eagletrt/fenice-bms-lv/docs/media/mcp23017 feedbacks.png

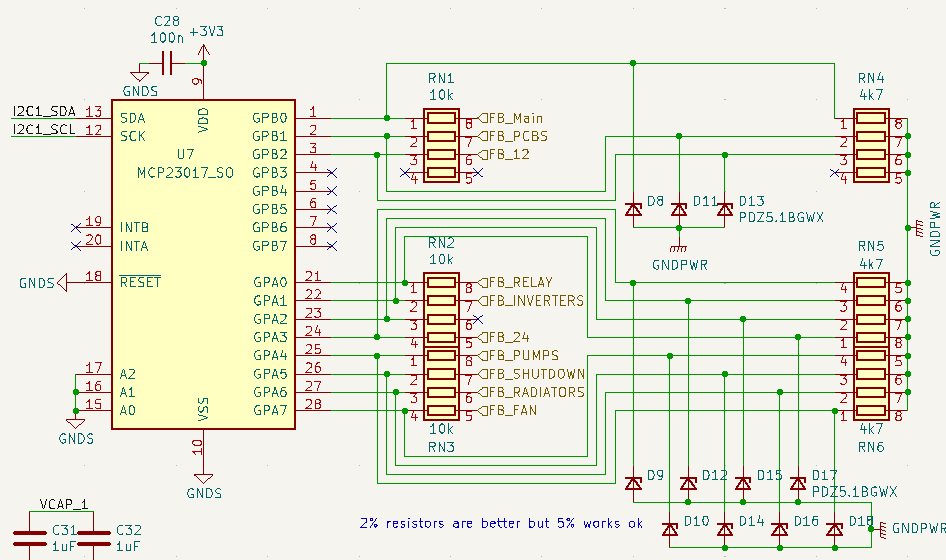
docs/media/mcp23017 feedbacks.png
