eagletrt/fenice-bms-lv/docs/media/pinout_mcu.png

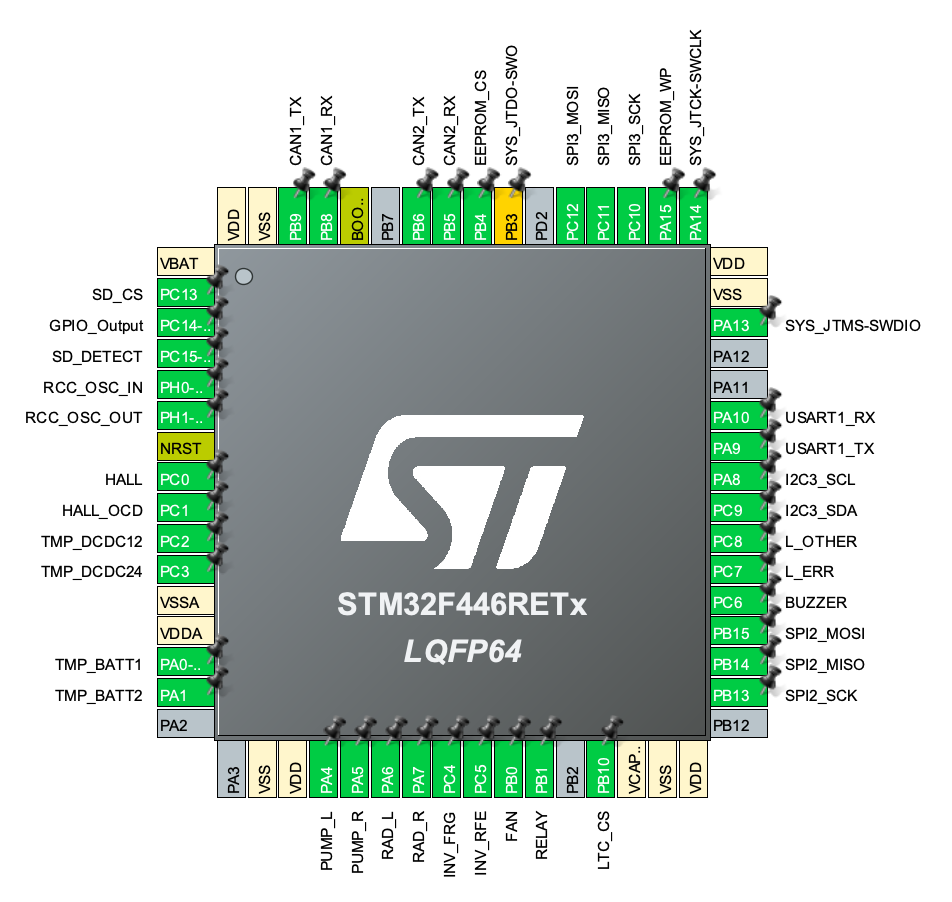
docs/media/pinout_mcu.png
