eagletrt/fenice-bms-lv/Doc/fenice-bms-lv-hw.pdf

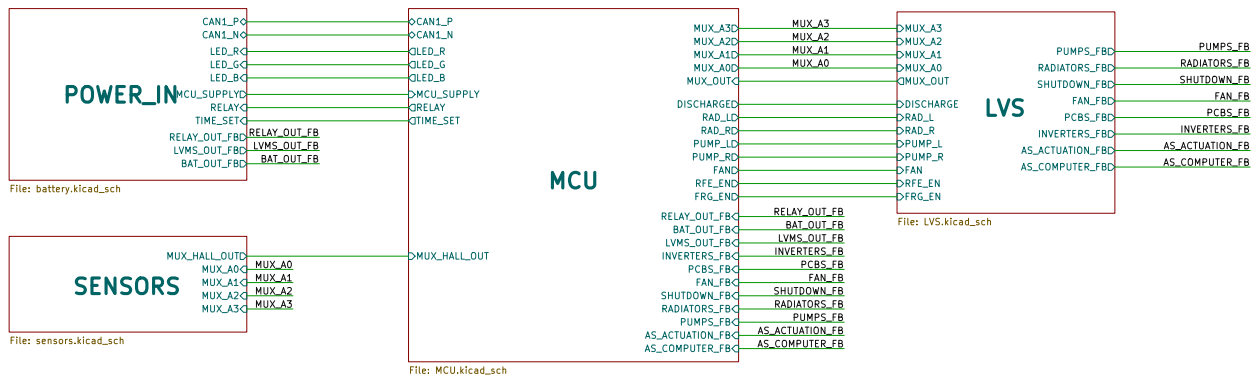
[picture p7: page 1]

File: fenice-bms-lv-hw.kicad_sch Sheet: / E-Agle TRT

Id: 1/5 Title: Fenice BMS LV

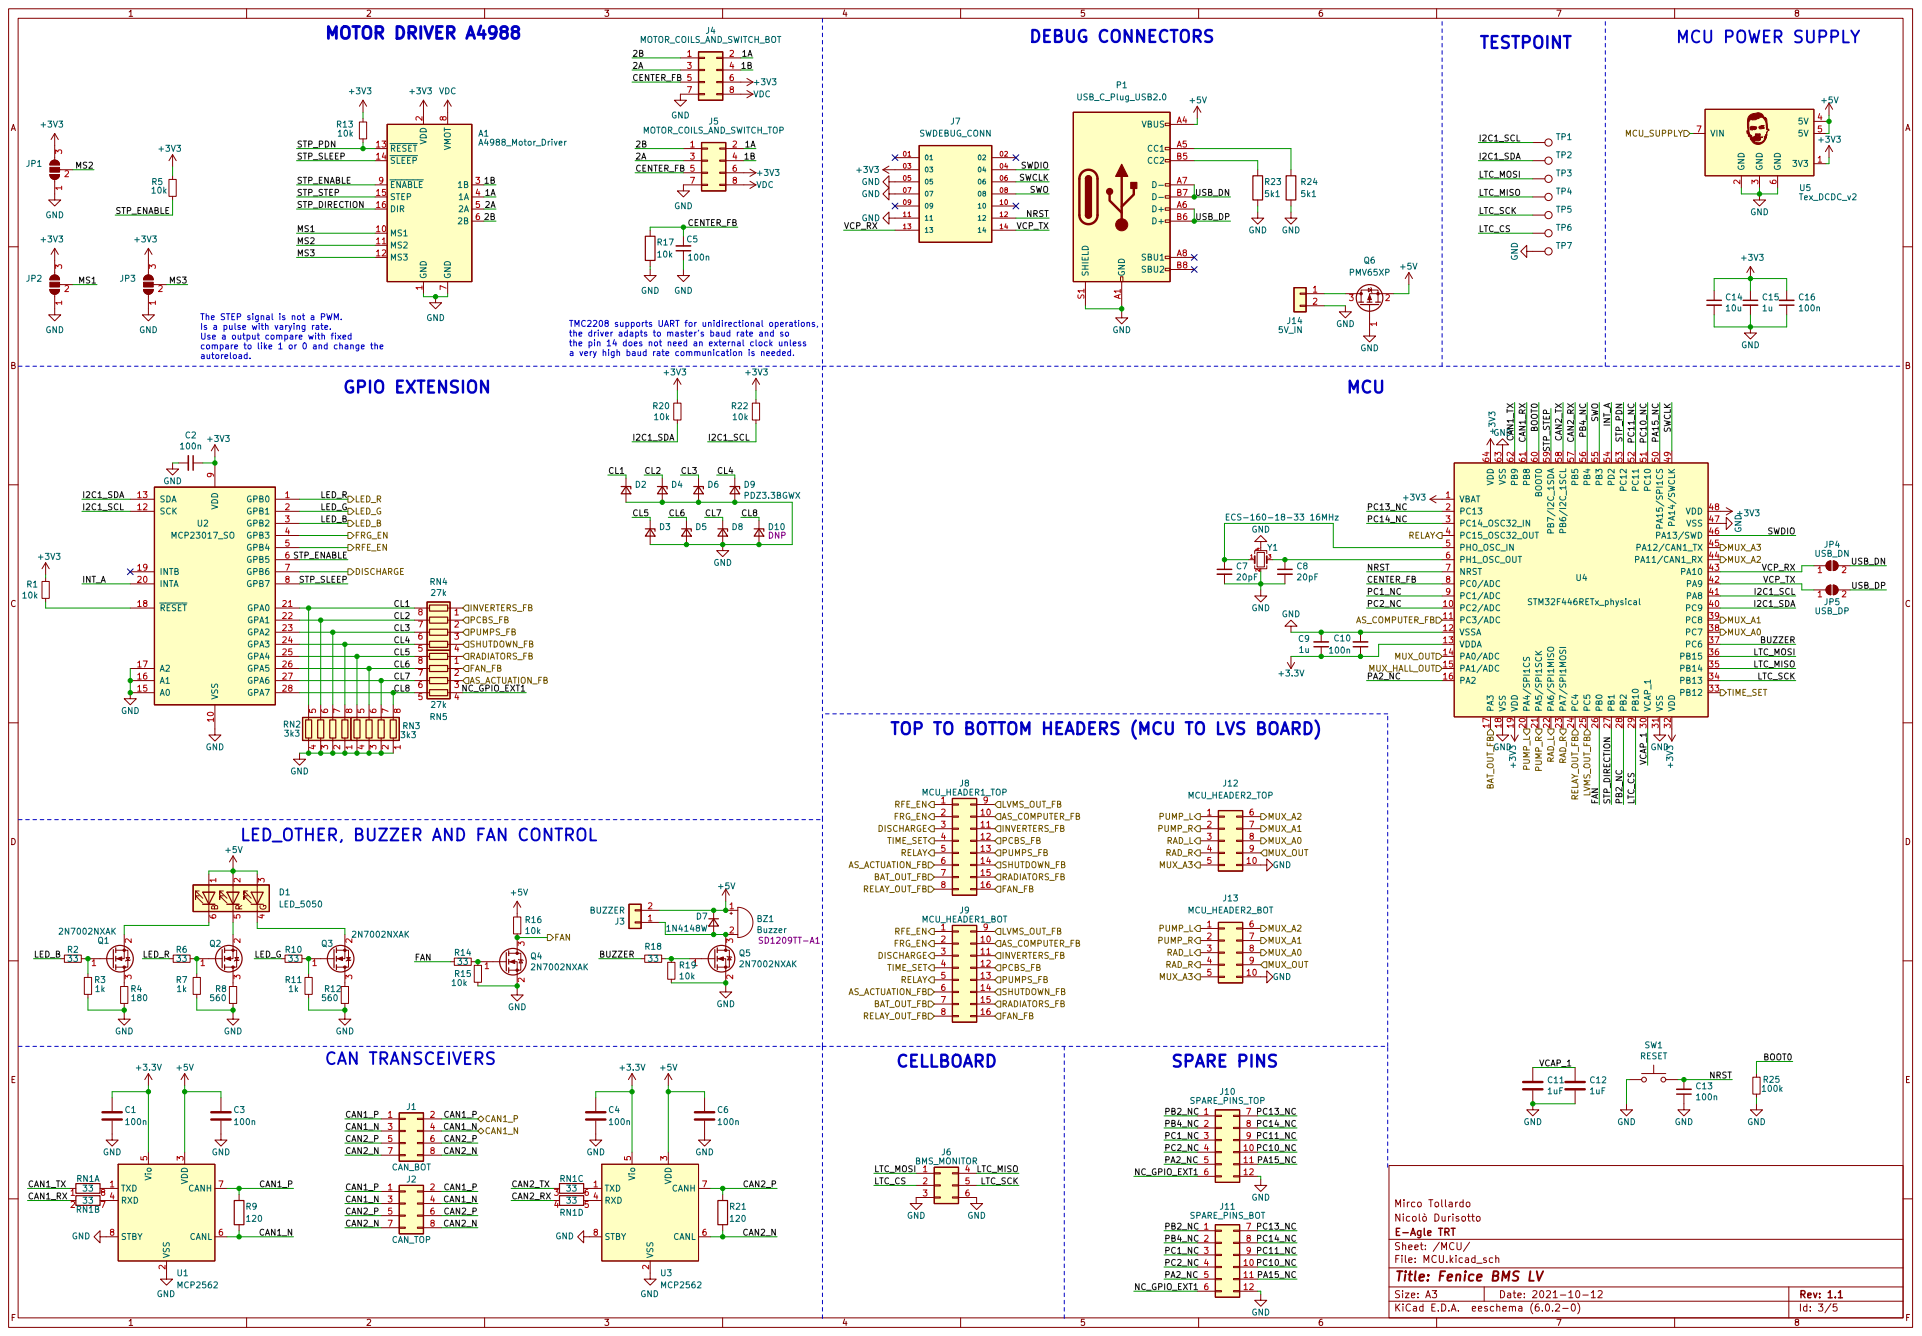
[picture p8: page 2]

1 MS1 10 MS2 11 MS3 12 ~{RESET} 13 ~{SLEEP} 14 STEP 15 DIR 16 VDD

The STEP signal is not a PWM.
Is a pulse with varying rate.
Use a output compare with fixed

TMC2208 supports UART for unidirectional operations,
the driver adapts to master's baud rate and so
the pin 14 does not need an external clock unless
a very high baud rate communication is needed.

LED_OTHER, BUZZER AND FAN CONTROL

5 CANL 6 CANH 7 STBY 8 U3MCP2562 GND GND

5 CANL 6 CANH 7 STBY 8 U1MCP2562 GND

File: MCU.kicad_sch Sheet: /MCU/ E-Agle TRT

Id: 3/5 Title: Fenice BMS LV

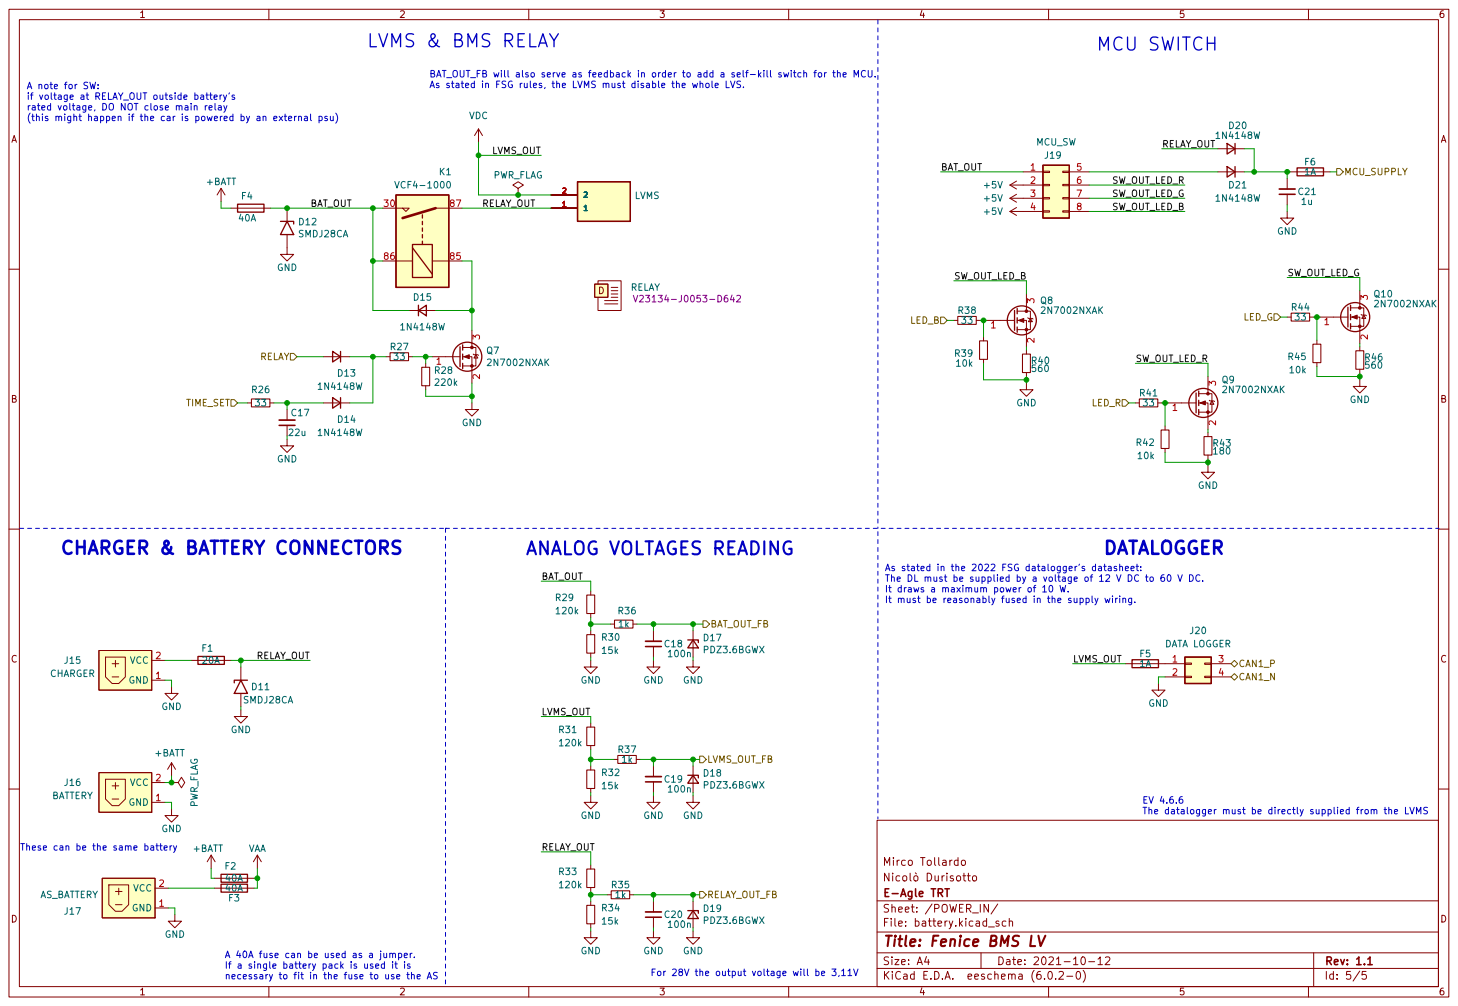
[picture p9: page 3]

A note for SW:
if voltage at RELAY_OUT outside battery's
rated voltage, DO NOT close main relay
(this might happen if the car is powered by an external psu)

The DL must be supplied by a voltage of 12 V DC to 60 V DC.
It draws a maximum power of 10 W.
It must be reasonably fused in the supply wiring.

EV 4.6.6 The datalogger must be directly supplied from the LVMS

These can be the same battery

E-Agle TRT
Sheet: /POWER_IN/
File: battery.kicad_sch
Id: 5/5 Title: Fenice BMS LV

A 40A fuse can be used as a jumper.
If a single battery pack is used it is
necessary to fit in the fuse to use the AS

For 28V the output voltage will be 3,11V

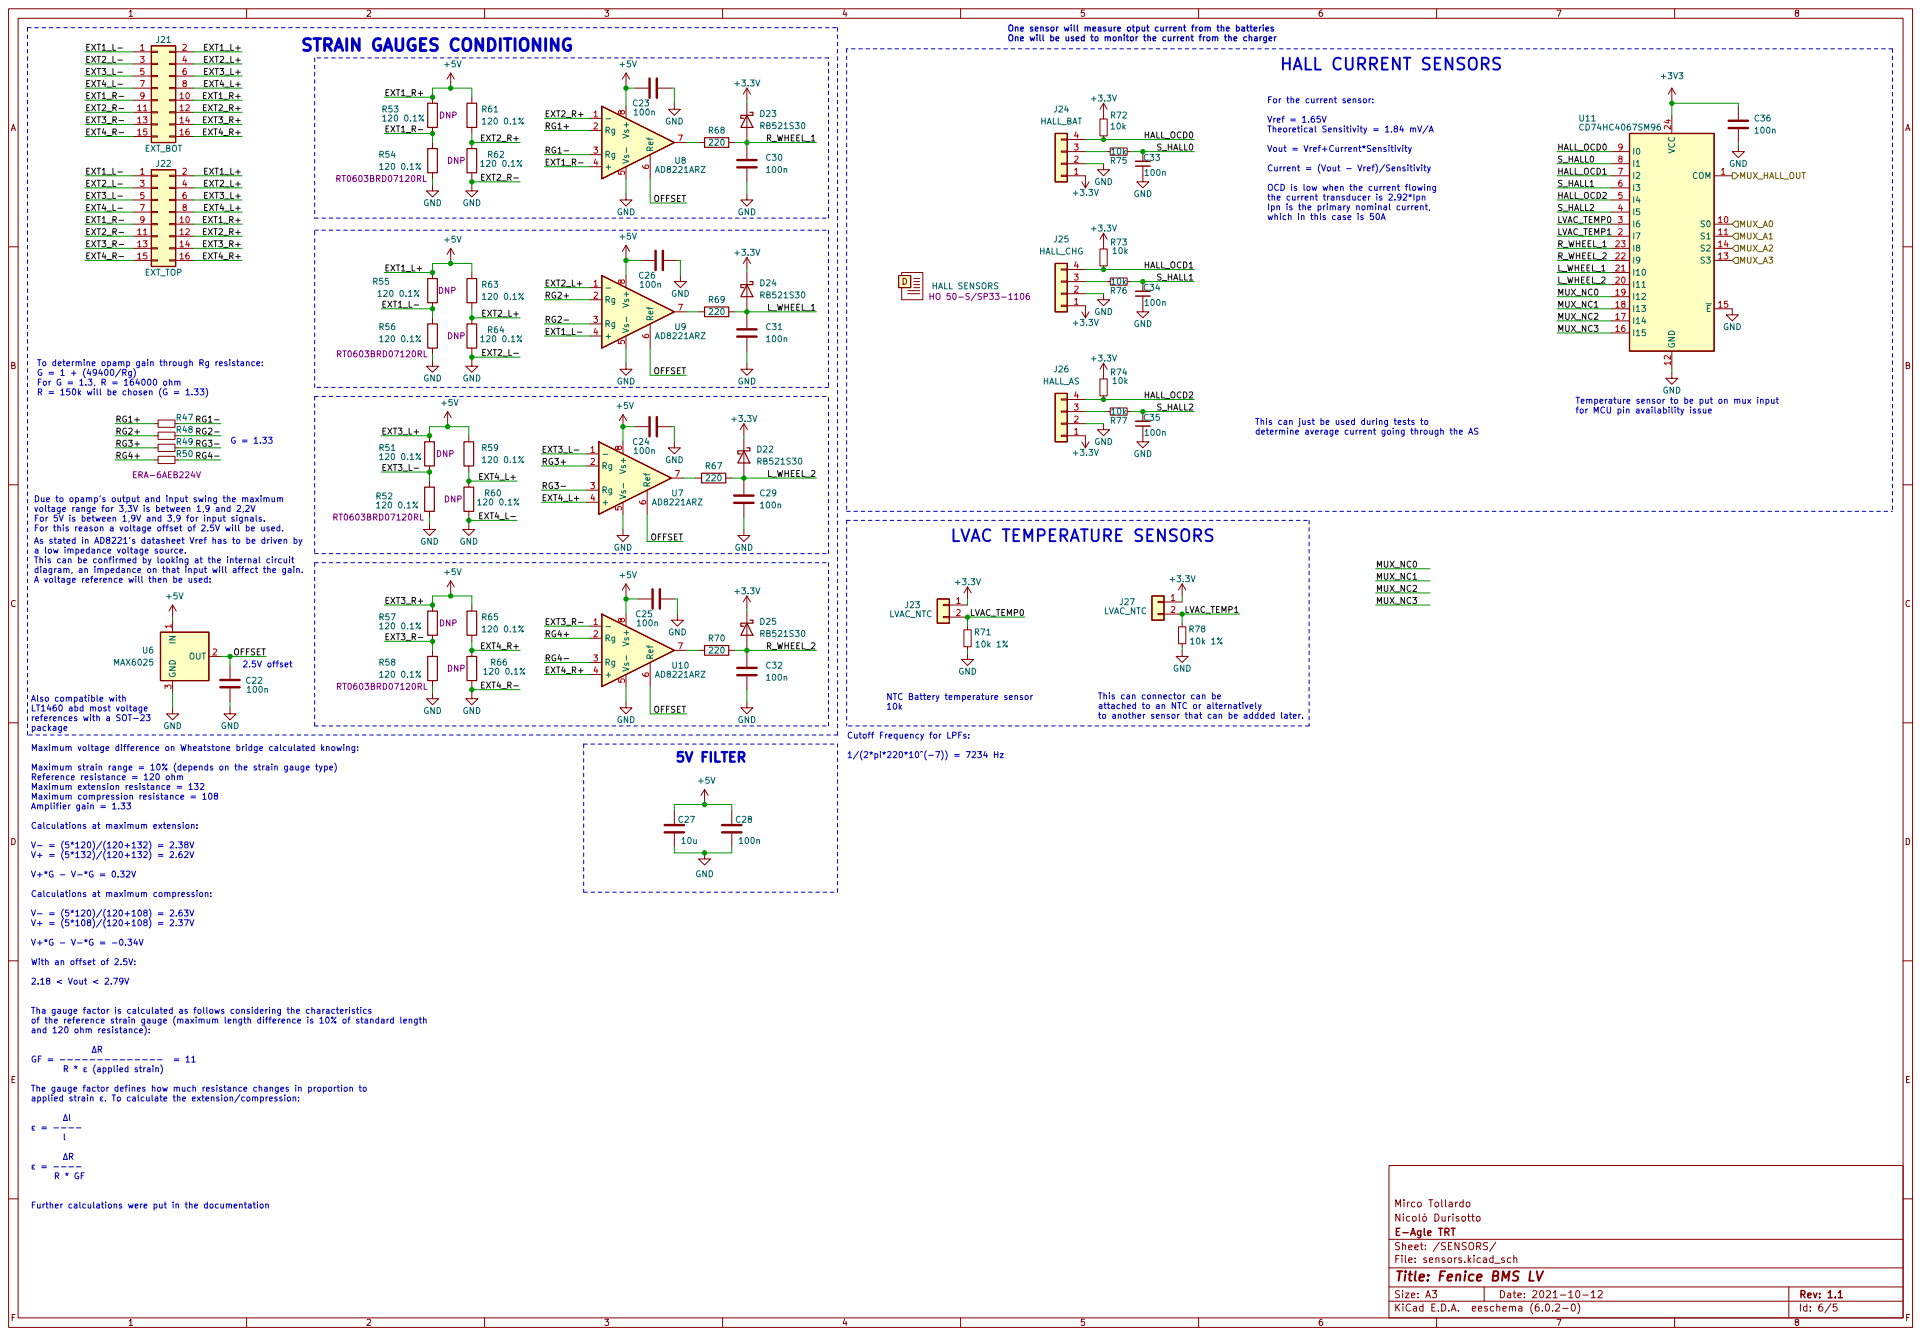
[picture p10: page 4]

One sensor will measure otput current from the batteries
One will be used to monitor the current from the charger

Ipn is the primary nominal current, which in this case is 50A STRAIN GAUGES CONDITIONING

For the current sensor: Vref = 1.65V

Vout = Vref+Current*Sensitivity

Current = (Vout - Vref)/Sensitivity

OCD is low when the current flowing
the current transducer is 2.92*Ipn

to another sensor that can be addded later. To determine opamp gain through Rg resistance:
G = 1 + (49400/Rg) For G = 1.3, R = 164000 ohm

Temperature sensor to be put on mux input
for MCU pin availability issue

This can just be used during tests to
determine average current going through the AS

Due to opamp's output and input swing the maximum
voltage range for 3,3V is between 1,9 and 2,2V
For 5V is between 1,9V and 3,9 for input signals.
As stated in AD8221's datasheet Vref has to be driven by
a low impedance voltage source.
This can be confirmed by looking at the internal circuit
diagram, an impedance on that input will affect the gain.
A voltage reference will then be used:

This can connector can be attached to an NTC or alternatively

Also compatible with
LT1460 abd most voltage references with a SOT-23

Cutoff Frequency for LPFs:

Maximum voltage difference on Wheatstone bridge calculated knowing:

Maximum strain range = 10% (depends on the strain gauge type) Reference resistance = 120 ohm

Maximum extension resistance = 132 Maximum compression resistance = 108

Amplifier gain = 1.33 Calculations at maximum extension: V- = (5*120)/(120+132) = 2.38V

V+*G - V-*G = 0.32V Calculations at maximum compression:

V+*G - V-*G = -0.34V With an offset of 2.5V: 2.18 < Vout < 2.79V

Tha gauge factor is calculated as follows considering the characteristics
of the reference strain gauge (maximum length difference is 10% of standard length
and 120 ohm resistance):

The gauge factor defines how much resistance changes in proportion to

Further calculations were put in the documentation

File: sensors.kicad_sch Sheet: /SENSORS/ E-Agle TRT

Id: 6/5 Title: Fenice BMS LV

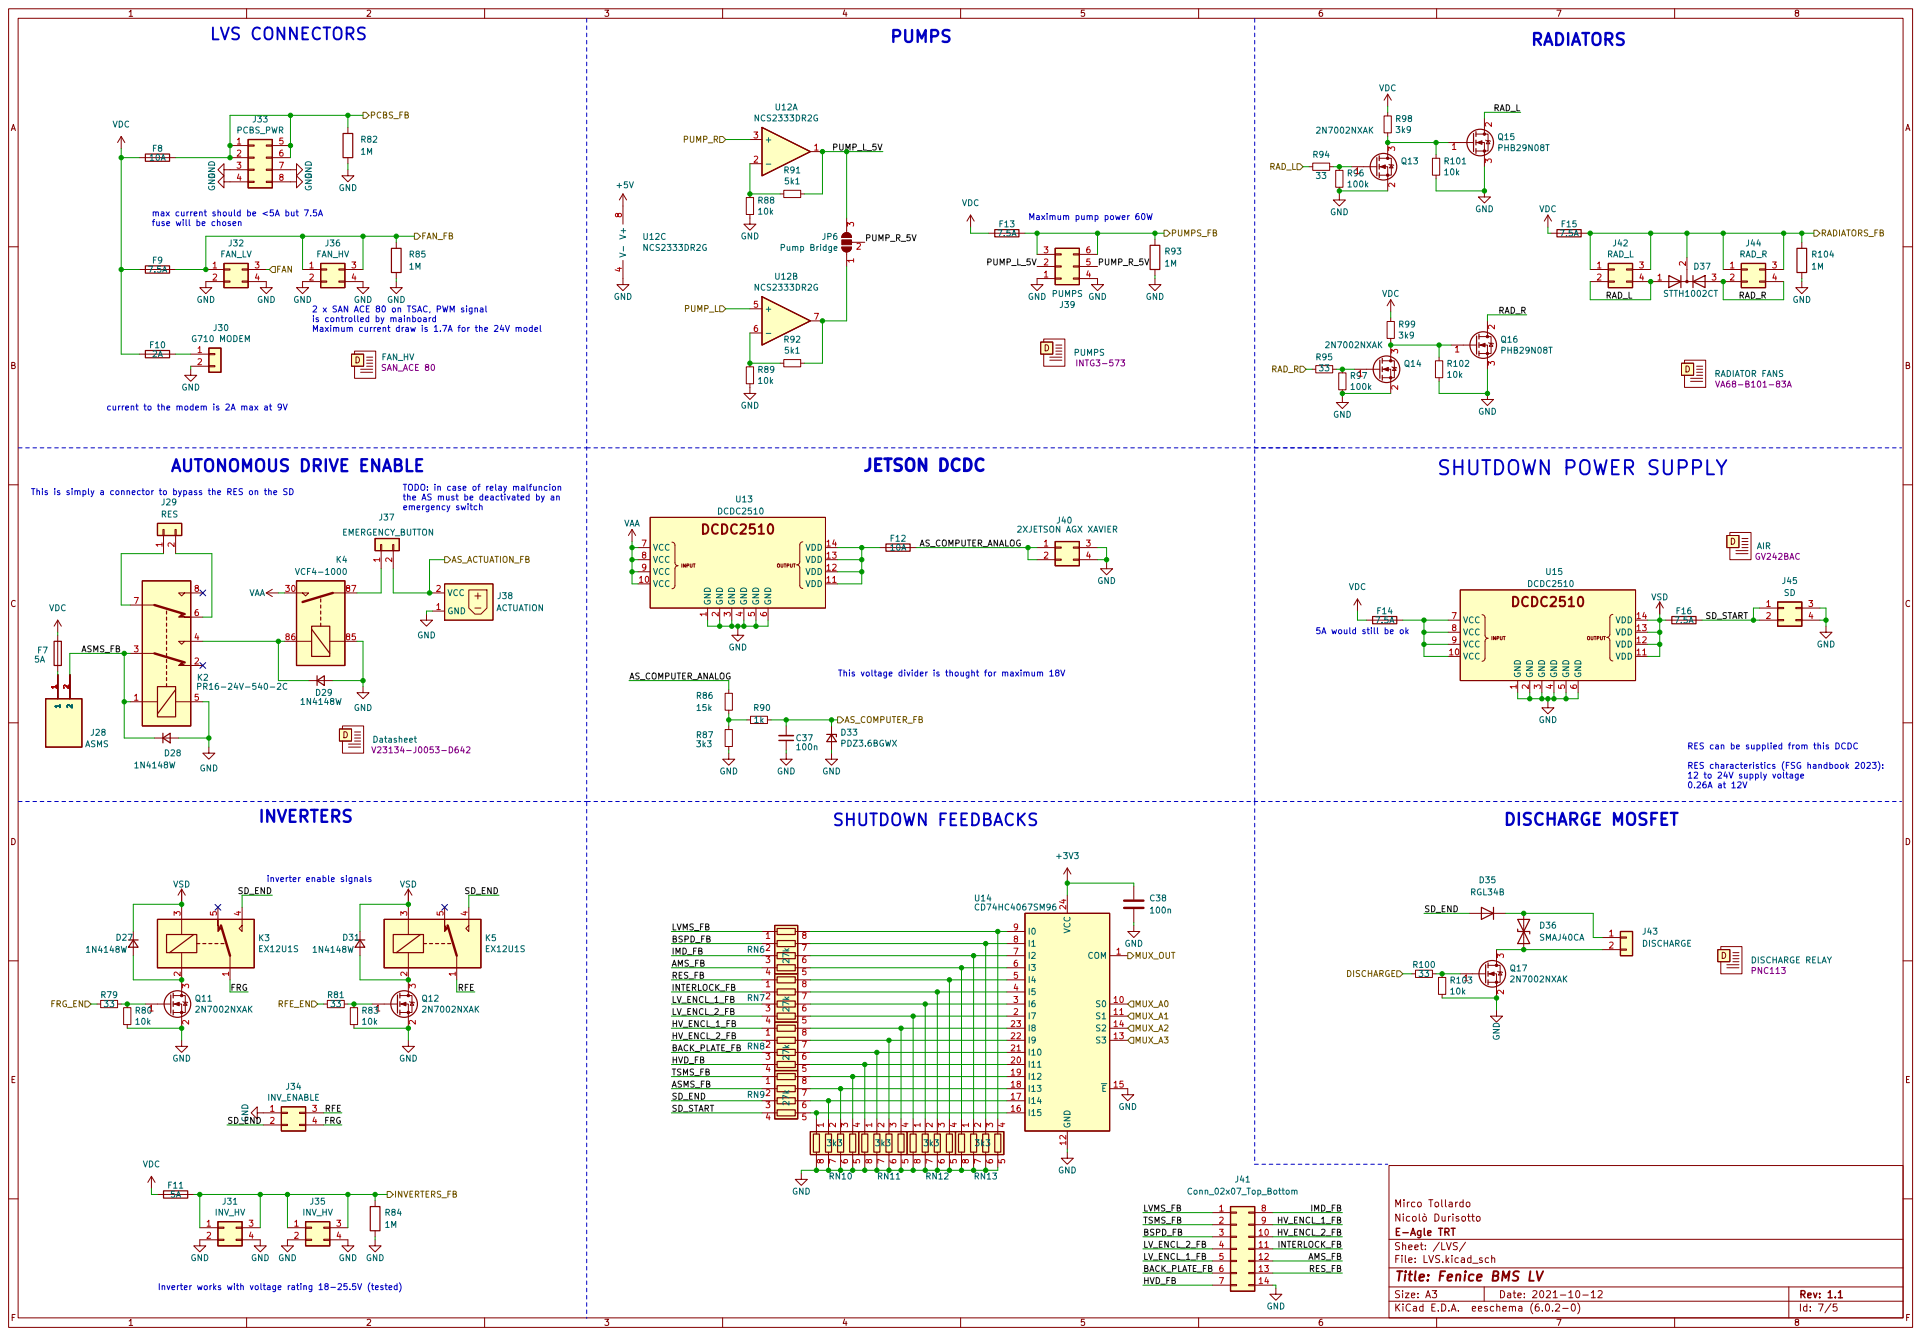
[picture p11: page 5]

max current should be <5A but 7.5A
fuse will be chosen

6 VCC 7 VCC 8 VCC 9 U15 DCDC2510 GND GND GND GNDV- 4 V+
J32 FAN_LV GND

2 x SAN ACE 80 on TSAC, PWM signal
is controlled by mainboard Maximum current draw is 1.7A for the 24V model

This is simply a connector to bypass the RES on the SD

TODO: in case of relay malfuncion
the AS must be deactivated by an
emergency switch

1 VCC 10 VDD 11 VDD 12 VDD 13 VDD 14 GND

This voltage divider is thought for maximum 18V

RES characteristics (FSG handbook 2023):
12 to 24V supply voltage

þÿNicolò Durisotto Mirco Tollardo GND

File: LVS.kicad_sch Sheet: /LVS/ E-Agle TRT

Id: 7/5 Title: Fenice BMS LV

Inverter works with voltage rating 18-25.5V (tested)
