eagletrt/fenice-bms-lv/Core/Src/main.c

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
/* Includes ------------------------------------------------------------------*/
#include "main.h"

#include "can.h"
#include "dac.h"
#include "gpio.h"
#include "i2c.h"
#include "spi.h"
#include "tim.h"
#include "usart.h"

/* USER CODE BEGIN Includes */
#include "adc.h"
#include "can_comm.h"
#include "cli_bms_lv.h"
#include "common.h"
#include "current_sensor.h"
#include "current_transducer.h"
#include "dac_pump.h"
#include "dma.h"
#include "error.h"
#include "fenice-config.h"
#include "health_signals.h"
#include "inverters.h"
#include "mcp23017.h"
#include "measurements.h"
#include "monitor_int.h"
#include "notes_buzzer.h"
#include "pwm.h"
#include "radiator.h"
#include "stdio.h"
#include "string.h"
#include "thermocouple.h"
#include "timer_utils.h"
/* USER CODE END Includes */

/* USER CODE BEGIN PTD */

/*----------------------------------- ERRORS ---------------------------------*/

bool is_bms_on_fault                   = false;
bool is_relay_closed                   = false;
bool is_lvms_closed_for_the_first_time = false;
/* USER CODE END PTD */


/* USER CODE BEGIN PV */
Inverters_struct car_inverters;
/* USER CODE END PV */

void SystemClock_Config(void);
/* USER CODE BEGIN PFP */
void bms_error_state();
void cooling_routine();
void lv_under_v_alert();
void check_lvms();
static inline void check_initial_voltage();
static inline void fans_radiators_pumps_init();
void set_flash_pin();
/* USER CODE END PFP */

/* USER CODE BEGIN 0 */
int debug_flag  = 0;
int m_sec_timer = 0;

HAL_StatusTypeDef status;
char main_buff[500];
float bms_fan_duty_cycle = 0.8;
bool cooling_update      = false;
uint32_t init_timer;
/* USER CODE END 0 */

/**
  * @brief  The application entry point.
  * @retval int
  */
int main(void) {
    /* MCU Configuration--------------------------------------------------------*/

    /* Reset of all peripherals, Initializes the Flash interface and the Systick. */
    HAL_Init();

    /* Configure the system clock */
    SystemClock_Config();

    /* Initialize all configured peripherals */
    MX_GPIO_Init();
    MX_CAN2_Init();
    MX_DAC_Init();
    MX_I2C3_Init();
    MX_SPI2_Init();
    MX_TIM2_Init();
    MX_TIM3_Init();
    MX_USART1_UART_Init();
    MX_CAN1_Init();
    MX_TIM8_Init();
    MX_TIM5_Init();
    MX_TIM7_Init();
    MX_TIM4_Init();
    MX_UART5_Init();
    MX_TIM10_Init();
    MX_TIM1_Init();
    /* USER CODE BEGIN 2 */
    /* USER CODE BEGIN 2 */

    //  MX_DMA_Init() must be executed before MX_ADC_Init() otherwise the ADC doesnt' work in DMA mode correctly
    //  but since __CUBEMIX e' stronzo__(cit.), this isn't enforced by the code generator
    //  threfore manual intervention is necessary
    //  https://community.st.com/s/question/0D50X0000ALudz8SQB/how-to-enable-adc-continuous-mode-with-dma

    MX_DMA_Init();
    MX_ADC1_Init();
    MX_ADC2_Init();

    // Usefull if it's necessary to stop the timer counter when debugging
#ifdef DEBUG_TIMER_MCU
    DBGMCU->APB2FZ = DBGMCU_APB2_FZ_DBG_TIM10_STOP;
#endif

    // START OF WARM UP STAGE
    lv_status.status = PRIMARY_LV_STATUS_STATUS_INIT_CHOICE;
    // Turn on startup button
    // TODO: change button pin

    // Blink to signal correct MX_XXX_init processes (usuefull for CAN transciever)
    cli_bms_lv_init();
    error_init();
    health_init(&hs);

    //Init ADC related stuff
    ADC_init_status_flags();
    ADC_init_mux();
    ADC_Vref_Calibration();
    ADC_start_ADC2_readings();

    monitor_init();

    init_inverter_struct(&car_inverters);
    //Init feedbacks chip
    mcp23017_basic_config_init(&hmcp, &hi2c3);
    radiator_init();
    dac_pump_handle_init(&hdac_pump, 0.0, 0.0);
    dac_pump_store_and_set_value_on_both_channels(&hdac_pump, 0.0, 0.0);

    // Buzzer congiguration
    pwm_set_period(&BZZR_HTIM, 1);
    pwm_set_duty_cicle(&BZZR_HTIM, BZZR_PWM_TIM_CHNL, 0.25);

    // Other fan, set at 25 KHz
    // pwm_set_period(&INTERNAL_FAN_HTIM, 0.04);
    // pwm_set_duty_cicle(&INTERNAL_FAN_HTIM, INTERNAL_FAN_PWM_TIM_CHNL, 0.9);
    // pwm_start_channel(&INTERNAL_FAN_HTIM, INTERNAL_FAN_PWM_TIM_CHNL);
    // pwm_start_channel(&BZZR_HTIM, BZZR_PWM_TIM_CHNL);

    // Keeps SPI CS high
    // ltc6810_disable_cs(&SPI);
#ifdef DEBUG_LTC_ID
    sprintf(main_buff, "LTC ID %s", ltc6810_return_serial_id());
    printl(main_buff, NO_HEADER);
#endif

    printl("Relay out disabled, waiting 0.5 seconds before reading voltages\r\n", NO_HEADER);
    HAL_Delay(500);

    check_initial_voltage();
    set_flash_pin();
    check_lvms();

    //fans_radiators_pumps_init();

    //init for both can
    can_primary_init();
    can_secondary_init();

    measurements_init(&MEASUREMENTS_TIMER);
    // END OF WARM UP STAGE

    /* USER CODE END 2 */

    /* Infinite loop */
    /* USER CODE BEGIN WHILE */
    init_timer = HAL_GetTick();
    mcp23017_set_gpio(&hmcp, MCP23017_PORTB, LED_R, 1);
    if (lv_status.status == PRIMARY_LV_STATUS_STATUS_INIT_CHOICE) {
        lv_status.status = PRIMARY_LV_STATUS_STATUS_RUN_CHOICE;
    }

    //start timer for cooling routine
    HAL_TIM_Base_Start_IT(&htim7);
    //static bool first = true;
    while (1) {
        // Running stage
        if (lv_status.status == PRIMARY_LV_STATUS_STATUS_ERROR_CHOICE) {
            bms_error_state();
        } else {
            ADC_Routine();
            if (HAL_GetTick() - init_timer > 3000) {
                measurements_flags_check();
            }

            inverters_loop(&car_inverters);
            if (lv_thresholds_handler.first_threshold_reached || lv_thresholds_handler.second_threshold_reached) {
                lv_under_v_alert();
            }
            if (cooling_update) {
                cooling_routine();
                cooling_update = false;
            }
            cli_loop(&cli_bms_lv);
        }
    }
    /* USER CODE END WHILE */

    /* USER CODE BEGIN 3 */
    // }
    /* USER CODE END 3 */
}

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
/* USER CODE BEGIN 4 */

/* Exported functions --------------------------------------------------------*/

/**
  * @brief  RCC Clock Security System interrupt callback
  * @retval None
  */
void HAL_RCC_CSSCallback(void) {
    //TODO change into something meaningfull
    for (int i = 0; i < 3; i++) {
        //HAL_GPIO_TogglePin(LED_ERR_GPIO_Port, LED_ERR_Pin);
        HAL_Delay(100);
    }
}

/**
 * @brief Checks if total voltage is above MIN_POWER_ON_VOLTAGE within VOLT_MAX_ATTEMPTS times
 * If total voltage is above the minimum level required the buzzer starts up for BUZZER_ALARM_TIME
 * 
 */
static inline void check_initial_voltage() {
    sprintf(main_buff, "Checking if total voltage on board is above %.2fV", MIN_POWER_ON_VOLTAGE);
    for (uint8_t i = 0; i < VOLT_MAX_ATTEMPTS; i++) {
        sprintf(main_buff, "Closing relay phase: attempt %d of %d", i + 1, VOLT_MAX_ATTEMPTS);
        printl(main_buff, NO_HEADER);
        if (monitor_print_volt() == VOLT_OK) {
            printl("Relay on", NORM_HEADER);
            LV_MASTER_RELAY_set_state(GPIO_PIN_SET, true);
            i = VOLT_MAX_ATTEMPTS;
            printl("DONE!\r\n", NORM_HEADER);
            is_relay_closed = true;
        }
        HAL_Delay(200);
    }

    if (volt_status != VOLT_OK) {
        error_set(ERROR_RELAY, 0);
        //is_bms_on_fault = true;
    } else {
        error_reset(ERROR_RELAY, 0);
    }
}

/**
 * @brief Initialize internal fan, pumps and radiator with standard value
 * Also set/reset the relative errors
 * 
 */
static inline void fans_radiators_pumps_init() {
    // if (FDBK_12V_FANS_get_state()) {
    //     pwm_start_channel(&INTERNAL_FAN_HTIM, INTERNAL_FAN_PWM_TIM_CHNL);
    //     error_reset(ERROR_FAN, 0);
    // } else {
    //     error_set(ERROR_FAN, 0);
    // }

    // if (FDBK_12V_RADIATORS_get_state()) {
    //     start_both_radiator(&RAD_R_HTIM, RAD_L_PWM_TIM_CHNL, RAD_R_PWM_TIM_CHNL);
    //     error_reset(ERROR_RADIATOR, 0);
    // } else {
    //     error_set(ERROR_RADIATOR, 0);
    // }
    // if (FDBK_24V_PUMPS_get_state()) {
    //     dac_pump_handle_init(&hdac_pump, 0.0, 0.0);
    //     error_reset(ERROR_PUMP, 0);
    // } else {
    //     error_set(ERROR_PUMP, 0);
    // }
#ifdef PUMP_SAMPLE_TEST
    if (FDBK_24V_PUMPS_get_state()) {
        dac_pump_sample_test(&hdac_pump);
    }
#endif
}

/**
 * @brief Error routine executed when the bms is on fault
 * 
 */
void bms_error_state() {
#define ERR_NOISE
#ifdef ERR_NOISE
    pwm_set_period(&BZZR_HTIM, 0.8);
    pwm_set_duty_cicle(&BZZR_HTIM, BZZR_PWM_TIM_CHNL, 0.9);
    pwm_start_channel(&BZZR_HTIM, BZZR_PWM_TIM_CHNL);
#endif
    printl("ERROR STATE \n", ERR_HEADER);

    char out[4000];
    size_t count = 0;
    error_t errors[ERROR_NUM_ERRORS];
    bool lvms_reset = false;
    error_dump(errors, &count);

    uint32_t now = HAL_GetTick();
    sprintf(out, "total %u\r\n", count);
    for (uint16_t i = 0; i < count; i++) {
        sprintf(
            out + strlen(out),
            "\r\nid..........%i (%s)\r\n"
            "timestamp...T+%lu (%lums ago)\r\n"
            "offset......%u\r\n"
            "state.......%s\r\n",
            errors[i].id,
            error_names[errors[i].id],
            errors[i].timestamp,
            now - errors[i].timestamp,
            errors[i].offset,
            errors[i].state == STATE_WARNING ? "warning" : "fatal");
    }
    printl(out, ERR_HEADER);

    can_primary_send(PRIMARY_LV_ERRORS_FRAME_ID, 0);
    can_primary_send(PRIMARY_LV_HEALTH_SIGNALS_FRAME_ID, 0);
    can_primary_send(PRIMARY_LV_STATUS_FRAME_ID, 0);
    HAL_GPIO_WritePin(TIME_SET_GPIO_Port, TIME_SET_Pin, GPIO_PIN_RESET);
    while (HAL_GetTick() - now < 5000) {
        ADC_Routine();
        measurements_flags_check();
        if (!lvms_reset && adcs_converted_values.lvms_out < HIGH_LEVEL_BITSET_THRESHOLD_SCALED) {
            lvms_reset = true;
        }

        if (lvms_reset && adcs_converted_values.lvms_out > HIGH_LEVEL_BITSET_THRESHOLD_SCALED) {
            HAL_GPIO_WritePin(TIME_SET_GPIO_Port, TIME_SET_Pin, GPIO_PIN_SET);
            HAL_Delay(500);
            HAL_NVIC_SystemReset();
        }
    }

    // ERROR stage
    mcp23017_set_gpio(&hmcp, MCP23017_PORTB, LED_R, 0);
    mcp23017_set_gpio(&hmcp, MCP23017_PORTB, LED_G, 1);
    LV_MASTER_RELAY_set_state(GPIO_PIN_RESET, true);
    is_relay_closed = false;
    error_state_inverters(&car_inverters);
    while (1) {
        ADC_Routine();
        // measure and sends via can
        measurements_flags_check();
        cli_loop(&cli_bms_lv);
    }
}

void lv_under_v_alert() {
    uint32_t current_time = HAL_GetTick();
    pwm_set_period(&BZZR_HTIM, 0.4);
    pwm_set_duty_cicle(&BZZR_HTIM, BZZR_PWM_TIM_CHNL, 0.8);
    if (!lv_thresholds_handler.second_threshold_reached && lv_thresholds_handler.first_threshold_reached &&
        lv_thresholds_handler.first_ths_buzzer_toggles < MAX_BZR_LV_ALERTS) {
        if (lv_thresholds_handler.first_ths_buzzer_toggles % 2 == 0) {
            pwm_start_channel(&BZZR_HTIM, BZZR_PWM_TIM_CHNL);
        } else {
            pwm_stop_channel(&BZZR_HTIM, BZZR_PWM_TIM_CHNL);
        }
        if (current_time - lv_thresholds_handler.first_ths_timestamp > 1000) {
            lv_thresholds_handler.first_ths_timestamp = current_time;
            lv_thresholds_handler.first_ths_buzzer_toggles++;
        }
    }
    if (lv_thresholds_handler.second_threshold_reached &&
        lv_thresholds_handler.second_ths_buzzer_toggles < MAX_BZR_LV_ALERTS) {
        if (lv_thresholds_handler.second_ths_buzzer_toggles % 2 == 0) {
            pwm_start_channel(&BZZR_HTIM, BZZR_PWM_TIM_CHNL);
        } else {
            pwm_stop_channel(&BZZR_HTIM, BZZR_PWM_TIM_CHNL);
        }
        if (current_time - lv_thresholds_handler.second_ths_timestamp > 1000) {
            lv_thresholds_handler.second_ths_timestamp = current_time;
            lv_thresholds_handler.second_ths_buzzer_toggles++;
        }
    }
}

void check_lvms() {
    uint32_t lvms_check_timestamp = HAL_GetTick();
    while ((HAL_GetTick() - lvms_check_timestamp) < 1000) {
        ADC_Routine();
    }

    lvms_out_conversion();

    if (adcs_converted_values.lvms_out > HIGH_LEVEL_BITSET_THRESHOLD_SCALED) {
        pwm_start_channel(&BZZR_HTIM, BZZR_PWM_TIM_CHNL);
        HAL_Delay(BUZZER_ALARM_TIME);
        pwm_stop_channel(&BZZR_HTIM, BZZR_PWM_TIM_CHNL);
        mcp23017_set_gpio(&hmcp, MCP23017_PORTB, LED_R, 1);
    } else {
        LV_MASTER_RELAY_set_state(GPIO_PIN_RESET, true);
    }
}

/**
 * @brief Cooling routine of the car and internal BMS
 * Set values for: internal fan, radiators, pumps
 * 
 */
void cooling_routine() {
    float local_rad_speed, local_pump_speed;
    float temp = 0;
    float max_inv_temp =
        (car_inverters.inv_temps[0] > car_inverters.inv_temps[1] ? car_inverters.inv_temps[0]
                                                                 : car_inverters.inv_temps[1]);
    float max_motor_temp =
        (car_inverters.motor_temps[0] > car_inverters.motor_temps[1] ? car_inverters.motor_temps[0]
                                                                     : car_inverters.motor_temps[1]);

    temp = (max_inv_temp > max_motor_temp ? max_inv_temp : max_motor_temp);
#ifndef INTERNAL_FAN_DEBUG
    //bms_fan_duty_cycle = (INTERNAL_FAN_Q_FACTOR + (max_dcdc_temp * INTERNAL_FAN_M_FACTOR));
#endif
    //pwm_set_duty_cicle(&INTERNAL_FAN_HTIM, INTERNAL_FAN_PWM_TIM_CHNL, 1 - bms_fan_duty_cycle);
    // pwm_set_duty_cicle(&INTERNAL_FAN_HTIM, INTERNAL_FAN_PWM_TIM_CHNL, 0.5);
    // pwm_start_channel(&INTERNAL_FAN_HTIM, INTERNAL_FAN_PWM_TIM_CHNL);
    /* 
        When automatic mode == true the values are controlled by the BMS
        When automatic mode == false the values are controlled by the Steering Wheel
    */
    if (radiator_handle.automatic_mode) {
        set_radiator_duty_cycle(&RAD_L_HTIM, RAD_L_PWM_TIM_CHNL, get_radiator_duty_cycle(temp));
        set_radiator_duty_cycle(&RAD_R_HTIM, RAD_R_PWM_TIM_CHNL, get_radiator_duty_cycle(temp));
    } else {
        if (radiator_handle.update_value) {
            local_rad_speed = rads_speed_msg.radiators_speed * (MAX_RADIATOR_DUTY_CYCLE - MIN_RADIATOR_DUTY_CYCLE) +
                              MIN_RADIATOR_DUTY_CYCLE;
            if (rads_speed_msg.radiators_speed == 0) {
                local_rad_speed = 0;
            }
            // // Clipping to max duty cycle allowed to avoid overcurrent (when in combo with pumps)
            // if (local_rad_speed > MAX_RADIATOR_DUTY_CYCLE) {
            //     local_rad_speed = MAX_RADIATOR_DUTY_CYCLE;
            // }
            // // Clipping to minimum duty cycle allowed to spin the radiator
            // else if (local_rad_speed < MIN_RADIATOR_DUTY_CYCLE) {
            //     local_rad_speed = MIN_RADIATOR_DUTY_CYCLE;
            // }

            set_radiator_duty_cycle(&RAD_L_HTIM, RAD_L_PWM_TIM_CHNL, local_rad_speed);
            set_radiator_duty_cycle(&RAD_R_HTIM, RAD_R_PWM_TIM_CHNL, local_rad_speed);
            radiator_handle.update_value = false;
        }
    }

    if (hdac_pump.automatic_mode) {
        dac_pump_store_and_set_value_on_both_channels(
            &hdac_pump, dac_pump_get_voltage(temp), dac_pump_get_voltage(temp));
    } else {
        if (hdac_pump.update_value) {
            local_pump_speed = pumps_speed_msg.pumps_speed * (MAX_OPAMP_OUT - MIN_OPAMP_OUT) + MIN_OPAMP_OUT;

            if (pumps_speed_msg.pumps_speed == 0) {
                local_pump_speed = 0;
            }
            // Clipping to max duty cycle allowed to avoid overcurrent (when in combo with pumps)
            // if (local_pump_speed > MAX_OPAMP_OUT) {
            //     local_pump_speed = MAX_OPAMP_OUT;
            // }
            // // Clipping to minimum duty cycle allowed to spin the radiator
            // else if (local_pump_speed < MIN_OPAMP_OUT) {
            //     local_pump_speed = MIN_OPAMP_OUT;
            // }
            //dac_pump_store_and_set_value_on_both_channels(&hdac_pump, local_pump_speed, local_pump_speed);
            dac_pump_store_and_set_value_on_both_channels(&hdac_pump, local_pump_speed, local_pump_speed);

            hdac_pump.update_value = false;
        }
    }
}

void set_flash_pin() {
    GPIO_InitTypeDef GPIO_InitStruct = {0};
    HAL_GPIO_WritePin(TIME_SET_GPIO_Port, TIME_SET_Pin, GPIO_PIN_RESET);
    GPIO_InitStruct.Pin   = TIME_SET_Pin;
    GPIO_InitStruct.Mode  = GPIO_MODE_OUTPUT_PP;
    GPIO_InitStruct.Pull  = GPIO_NOPULL;
    GPIO_InitStruct.Speed = GPIO_SPEED_FREQ_LOW;
    HAL_GPIO_Init(TIME_SET_GPIO_Port, &GPIO_InitStruct);
}

/* USER CODE END 4 */
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
