eagletrt/fenice-bms-lv/fenice-bms-lv.ioc

Mcu.UserName=STM32F446RETx
PA0-WKUP.GPIO_Label=MUX_FB_OUT
PA0-WKUP.Signal=ADCx_IN0
PA1.GPIO_Label=MUX_HALL
PA1.Signal=ADCx_IN1
PA10.Signal=USART1_RX
PA11.GPIO_Label=MUX_A2
PA11.Signal=GPIO_Output
PA12.GPIO_Label=MUX_A3
PA12.Signal=GPIO_Output
PA13.Signal=SYS_JTMS-SWDIO
PA14.Signal=SYS_JTCK-SWCLK
PA2.GPIO_Label=VREF_ADC
PA2.Signal=ADCx_IN2
PA3.GPIO_Label=BATT_OUT_ANALOG_FB
PA3.Signal=ADCx_IN3
PA4.GPIO_Label=PUMP_L
PA4.Signal=COMP_DAC1_group
PA5.GPIO_Label=PUMP_R
PA5.Signal=COMP_DAC2_group
PA6.GPIO_Label=RAD_L
PA6.Signal=S_TIM3_CH1
PA7.GPIO_Label=RAD_R
PA7.Signal=S_TIM3_CH2
PA8.Signal=I2C3_SCL
PA9.Signal=USART1_TX
PB0.GPIO_Label=FAN
PB0.Signal=S_TIM3_CH3
PB1.GPIO_Label=STP_DIRECTION
PB1.Signal=S_TIM3_CH4
PB10.GPIO_Label=LTC_CS
PB10.Signal=GPIO_Output
PB12.GPIO_Label=TIME_SET
PB12.Signal=GPIO_Input
PB13.Signal=SPI2_SCK
PB14.Signal=SPI2_MISO
PB15.Signal=SPI2_MOSI
PB2.GPIO_Label=NC_MCU0
PB2.Signal=GPIO_Output
PB3.Signal=SYS_JTDO-SWO
PB4.GPIO_Label=NC_NC
PB4.Signal=GPIO_Output
PB5.Signal=CAN2_RX
PB6.Signal=CAN2_TX
PB7.GPIO_Label=STP_STEP
PB7.Signal=S_TIM4_CH2
PB8.Signal=CAN1_RX
PB9.Signal=CAN1_TX
PC0.GPIO_Label=CENTER_FB
PC0.Signal=GPIO_Input
PC1.GPIO_Label=PC1_NC
PC1.Signal=GPIO_Output
PC12.GPIO_Label=STP_PDN
PC12.Signal=UART5_TX
PC13.GPIO_Label=PC13_NC
PC13.Signal=GPIO_Output
PC14-OSC32_IN.GPIO_Label=PC14_NC
PC14-OSC32_IN.Signal=GPIO_Output
PC15-OSC32_OUT.GPIO_Label=RELAY
PC15-OSC32_OUT.Signal=GPIO_Output
PC3.GPIO_Label=AS_COMPUTER_FB
PC3.Signal=ADCx_IN13
PC4.GPIO_Label=REAY_OUT_ANALOG_FB
PC4.Signal=ADCx_IN14
PC5.GPIO_Label=LVMS_OUT_ANALOG_FB
PC5.Signal=ADCx_IN15
PC6.GPIO_Label=BUZZER
PC6.Signal=S_TIM8_CH1
PC7.GPIO_Label=MUX_A0
PC7.Signal=GPIO_Output
PC8.GPIO_Label=MUX_A1
PC8.Signal=GPIO_Output
PC9.Signal=I2C3_SDA
PD2.GPIO_Label=GPIO_EXTENSION_INTERRUPT_A
PD2.Signal=GPIO_Input
PH0-OSC_IN.Signal=RCC_OSC_IN
PH1-OSC_OUT.Signal=RCC_OSC_OUT
