eagletrt/fenice-bms-lv/Core/Inc/current_sensor.h

#ifndef __CURRENT_SENSOR_H__
#define __CURRENT_SENSOR_H__

#define REFERENCE_VOLTAGE 1650   //mV
#define VOLTAGE_OFFSET    1150   //mV
#define MAX_mA            50000  //mA
#define OFFSET            REFERENCE_VOLTAGE - VOLTAGE_OFFSET
#define RESOLUTION        4096  //2^12 bit
#define Vcc               3300  //mV

#include <inttypes.h>

uint32_t get_current();
uint32_t calc_current(uint32_t adcVAL);
void mean_current();
void push_into_array(uint32_t val);

#endif
