eagletrt/fenice-bms-lv/Core/Inc/main.h

#define PC13_NC_Pin                          GPIO_PIN_13
#define PC13_NC_GPIO_Port                    GPIOC
#define PC14_NC_Pin                          GPIO_PIN_14
#define PC14_NC_GPIO_Port                    GPIOC
#define RELAY_Pin                            GPIO_PIN_15
#define RELAY_GPIO_Port                      GPIOC
#define CENTER_FB_Pin                        GPIO_PIN_0
#define CENTER_FB_GPIO_Port                  GPIOC
#define PC1_NC_Pin                           GPIO_PIN_1
#define PC1_NC_GPIO_Port                     GPIOC
#define AS_COMPUTER_FB_Pin                   GPIO_PIN_3
#define AS_COMPUTER_FB_GPIO_Port             GPIOC
#define MUX_FB_OUT_Pin                       GPIO_PIN_0
#define MUX_FB_OUT_GPIO_Port                 GPIOA
#define MUX_HALL_Pin                         GPIO_PIN_1
#define MUX_HALL_GPIO_Port                   GPIOA
#define VREF_ADC_Pin                         GPIO_PIN_2
#define VREF_ADC_GPIO_Port                   GPIOA
#define BATT_OUT_ANALOG_FB_Pin               GPIO_PIN_3
#define BATT_OUT_ANALOG_FB_GPIO_Port         GPIOA
#define PUMP_L_Pin                           GPIO_PIN_4
#define PUMP_L_GPIO_Port                     GPIOA
#define PUMP_R_Pin                           GPIO_PIN_5
#define PUMP_R_GPIO_Port                     GPIOA
#define RAD_L_Pin                            GPIO_PIN_6
#define RAD_L_GPIO_Port                      GPIOA
#define RAD_R_Pin                            GPIO_PIN_7
#define RAD_R_GPIO_Port                      GPIOA
#define REAY_OUT_ANALOG_FB_Pin               GPIO_PIN_4
#define REAY_OUT_ANALOG_FB_GPIO_Port         GPIOC
#define LVMS_OUT_ANALOG_FB_Pin               GPIO_PIN_5
#define LVMS_OUT_ANALOG_FB_GPIO_Port         GPIOC
#define FAN_Pin                              GPIO_PIN_0
#define FAN_GPIO_Port                        GPIOB
#define STP_DIRECTION_Pin                    GPIO_PIN_1
#define STP_DIRECTION_GPIO_Port              GPIOB
#define NC_MCU0_Pin                          GPIO_PIN_2
#define NC_MCU0_GPIO_Port                    GPIOB
#define LTC_CS_Pin                           GPIO_PIN_10
#define LTC_CS_GPIO_Port                     GPIOB
#define TIME_SET_Pin                         GPIO_PIN_12
#define TIME_SET_GPIO_Port                   GPIOB
#define BUZZER_Pin                           GPIO_PIN_6
#define BUZZER_GPIO_Port                     GPIOC
#define MUX_A0_Pin                           GPIO_PIN_7
#define MUX_A0_GPIO_Port                     GPIOC
#define MUX_A1_Pin                           GPIO_PIN_8
#define MUX_A1_GPIO_Port                     GPIOC
#define MUX_A2_Pin                           GPIO_PIN_11
#define MUX_A2_GPIO_Port                     GPIOA
#define MUX_A3_Pin                           GPIO_PIN_12
#define MUX_A3_GPIO_Port                     GPIOA
#define STP_PDN_Pin                          GPIO_PIN_12
#define STP_PDN_GPIO_Port                    GPIOC
#define GPIO_EXTENSION_INTERRUPT_A_Pin       GPIO_PIN_2
#define GPIO_EXTENSION_INTERRUPT_A_GPIO_Port GPIOD
#define NC_NC_Pin                            GPIO_PIN_4
#define NC_NC_GPIO_Port                      GPIOB
#define STP_STEP_Pin                         GPIO_PIN_7
#define STP_STEP_GPIO_Port                   GPIOB
#define MAX_RADIATOR_DUTY_CYCLE          1.0  // 0.9
#define MIN_RADIATOR_DUTY_CYCLE          0.15
#define MAX_INTERNAL_FAN_DUTY_CYCLE      1.0
#define MIN_INTERNAL_FAN_DUTY_CYCLE      0.1
#define INTERNAL_FAN_M_FACTOR            (MAX_INTERNAL_FAN_DUTY_CYCLE - MIN_INTERNAL_FAN_DUTY_CYCLE) / (60 - 20)
#define INTERNAL_FAN_Q_FACTOR            (MIN_INTERNAL_FAN_DUTY_CYCLE) - (20 * INTERNAL_FAN_M_FACTOR)
#define MIN_INVERTER_TEMP_RADIATORS_ONLY 40.0
#define MAX_INVERTER_TEMP_RADIATORS_ONLY 60.0
#define MIN_INVERTER_TEMP_PUMPS_ONLY     35.0
#define MAX_INVERTER_TEMP_PUMPS_ONLY     60.0
#define CANP hcan1
#define CANS hcan2
#define LOG_HUART huart1
#define RAD_L_HTIM         htim3
#define RAD_L_PWM_TIM_CHNL TIM_CHANNEL_1
#define RAD_R_HTIM         htim3
#define RAD_R_PWM_TIM_CHNL TIM_CHANNEL_2
#define INTERNAL_FAN_HTIM         htim3
#define INTERNAL_FAN_PWM_TIM_CHNL TIM_CHANNEL_3
#define BZZR_HTIM         htim8
#define BZZR_PWM_TIM_CHNL TIM_CHANNEL_1
#define BUZZER_ALARM_TIME 200
#define PUMP_DAC    hdac
#define PUMP_L_CHNL DAC_CHANNEL_2
#define PUMP_R_CHNL DAC_CHANNEL_1
#define MEASUREMENTS_TIMER                               htim2
#define MEAS_ALL_ANALOG_SIGNALS_TIMER_CHANNEL            TIM_CHANNEL_1
#define MEAS_VOLTS_AND_TEMPS_TIMER_CHANNEL               TIM_CHANNEL_2
#define MEAS_LV_VERSION_AND_COOLING_TIMER_CHANNEL        TIM_CHANNEL_3
#define MEAS_CELL_TEMPS_TIMER_CHANNEL                    TIM_CHANNEL_4
#define MEAS_ALL_ANALOG_SIGNALS_TIMER_ACTIVE_CHANNEL     HAL_TIM_ACTIVE_CHANNEL_1
#define MEAS_VOLTS_AND_TEMPS_TIMER_ACTIVE_CHANNEL        HAL_TIM_ACTIVE_CHANNEL_2
#define MEAS_LV_VERSION_AND_COOLING_TIMER_ACTIVE_CHANNEL HAL_TIM_ACTIVE_CHANNEL_3
#define MEAS_CELL_TEMPS_TIMER_ACTIVE_CHANNEL             HAL_TIM_ACTIVE_CHANNEL_4
#define OPEN_WIRE_MEASUREMENT_TIMER                      htim4
#define OPEN_WIRE_TIMER_CHANNEL                          TIM_CHANNEL_2
#define OPEN_WIRE_TIMER_ACTIVE_CHANNEL                   HAL_TIM_ACTIVE_CHANNEL_2
#define HTIM_ERR htim5
#define TIMER_ADC_MEAS                htim10
#define TIMER_ADC_CALIBRATION         htim1
#define TIMER_ADC_CALIBRATION_CHANNEL TIM_CHANNEL_1
#define ADC_HALL_AND_FB               hadc2
#define CALIBRATION_ADC               hadc1
