eagletrt/fenice-bms-lv/Core/Src/usart.c

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
/* Includes ------------------------------------------------------------------*/
#include "usart.h"

/* USER CODE BEGIN 0 */
#include "cli_bms_lv.h"
#include "common.h"
#include "stdio.h"
#include "string.h"

/* USER CODE END 0 */

UART_HandleTypeDef huart5;
UART_HandleTypeDef huart1;

/* UART5 init function */
void MX_UART5_Init(void)
{

  huart5.Instance = UART5;
  huart5.Init.BaudRate = 115200;
  huart5.Init.WordLength = UART_WORDLENGTH_8B;
  huart5.Init.StopBits = UART_STOPBITS_1;
  huart5.Init.Parity = UART_PARITY_NONE;
  huart5.Init.Mode = UART_MODE_TX_RX;
  huart5.Init.HwFlowCtl = UART_HWCONTROL_NONE;
  huart5.Init.OverSampling = UART_OVERSAMPLING_16;
  if (HAL_HalfDuplex_Init(&huart5) != HAL_OK)
  {
    Error_Handler();
  }
}
/* USART1 init function */

void MX_USART1_UART_Init(void)
{

  huart1.Instance = USART1;
  huart1.Init.BaudRate = 115200;
  huart1.Init.WordLength = UART_WORDLENGTH_8B;
  huart1.Init.StopBits = UART_STOPBITS_1;
  huart1.Init.Parity = UART_PARITY_NONE;
  huart1.Init.Mode = UART_MODE_TX_RX;
  huart1.Init.HwFlowCtl = UART_HWCONTROL_NONE;
  huart1.Init.OverSampling = UART_OVERSAMPLING_16;
  if (HAL_UART_Init(&huart1) != HAL_OK)
  {
    Error_Handler();
  }
}

void HAL_UART_MspInit(UART_HandleTypeDef* uartHandle)
{

  GPIO_InitTypeDef GPIO_InitStruct = {0};
  if(uartHandle->Instance==UART5)
  {
    /* UART5 clock enable */
    __HAL_RCC_UART5_CLK_ENABLE();

    __HAL_RCC_GPIOC_CLK_ENABLE();
    /**UART5 GPIO Configuration
    PC12     ------> UART5_TX
    */
    GPIO_InitStruct.Pin = STP_PDN_Pin;
    GPIO_InitStruct.Mode = GPIO_MODE_AF_OD;
    GPIO_InitStruct.Pull = GPIO_NOPULL;
    GPIO_InitStruct.Speed = GPIO_SPEED_FREQ_VERY_HIGH;
    GPIO_InitStruct.Alternate = GPIO_AF8_UART5;
    HAL_GPIO_Init(STP_PDN_GPIO_Port, &GPIO_InitStruct);

  }
  else if(uartHandle->Instance==USART1)
  {
    /* USART1 clock enable */
    __HAL_RCC_USART1_CLK_ENABLE();

    __HAL_RCC_GPIOA_CLK_ENABLE();
    /**USART1 GPIO Configuration
    PA9     ------> USART1_TX
    PA10     ------> USART1_RX
    */
    GPIO_InitStruct.Pin = GPIO_PIN_9|GPIO_PIN_10;
    GPIO_InitStruct.Mode = GPIO_MODE_AF_PP;
    GPIO_InitStruct.Pull = GPIO_NOPULL;
    GPIO_InitStruct.Speed = GPIO_SPEED_FREQ_VERY_HIGH;
    GPIO_InitStruct.Alternate = GPIO_AF7_USART1;
    HAL_GPIO_Init(GPIOA, &GPIO_InitStruct);

    /* USART1 interrupt Init */
    HAL_NVIC_SetPriority(USART1_IRQn, 0, 0);
    HAL_NVIC_EnableIRQ(USART1_IRQn);
  }
}

void HAL_UART_MspDeInit(UART_HandleTypeDef* uartHandle)
{

  if(uartHandle->Instance==UART5)
  {
    /* Peripheral clock disable */
    __HAL_RCC_UART5_CLK_DISABLE();

    /**UART5 GPIO Configuration
    PC12     ------> UART5_TX
    */
    HAL_GPIO_DeInit(STP_PDN_GPIO_Port, STP_PDN_Pin);

  }
  else if(uartHandle->Instance==USART1)
  {
    /* Peripheral clock disable */
    __HAL_RCC_USART1_CLK_DISABLE();

    /**USART1 GPIO Configuration
    PA9     ------> USART1_TX
    PA10     ------> USART1_RX
    */
    HAL_GPIO_DeInit(GPIOA, GPIO_PIN_9|GPIO_PIN_10);

    /* USART1 interrupt Deinit */
    HAL_NVIC_DisableIRQ(USART1_IRQn);
  }
}

/* USER CODE BEGIN 1 */
volatile static bool _is_log_on = true;

void UART_disable_log(void) {
    printl("Logging disabled", UART_HEADER);
    _is_log_on = false;
};

void UART_enable_log(void) {
    _is_log_on = true;
    printl("Logging enabled", UART_HEADER);
};
bool UART_is_log_on() {
    return _is_log_on;
};

void printl(char *txt, UART_HeaderTypeDef header_type) {
    if (_is_log_on) {
        char *header;
        switch (header_type) {
            case NORM_HEADER:
                header = "\r\n[" M_NAME_TO_STR(MCU_NAME) "@fenice]~> ";
                break;
            case ERR_HEADER:
                header = "\r\n[" M_NAME_TO_STR(MCU_NAME) "@fenice]~> {!ERROR!} ";
                break;
            case CAN_HEADER:
                header = "\r\n[" M_NAME_TO_STR(MCU_NAME) "@fenice]~> {CAN} ";
                break;
            case CAN_ERR_HEADER:
                header = "\r\n[" M_NAME_TO_STR(MCU_NAME) "@fenice]~> {CAN !ERROR!} ";
                break;
            case UART_HEADER:
                header = "\r\n[" M_NAME_TO_STR(MCU_NAME) "@fenice]~> {UART} ";
                break;
            case NO_HEADER:
                header = "\r\n";
                break;
            case VOLT_HEADER:
                header = "\r\n[" M_NAME_TO_STR(MCU_NAME) "@fenice]~> {VOLT} ";
                break;
            case NOTHING:
            default:
                header = "";
                break;
        }
        char buf[200];
        sprintf(buf, "%s", header);
        strncat(buf, txt, 200 - strlen(buf) - 1);
        HAL_UART_Transmit(&LOG_HUART, (uint8_t *)buf, strlen(buf), 100);
    }
}

void HAL_UART_RxCpltCallback(UART_HandleTypeDef *huart) {
    cli_handle_interrupt(&cli_bms_lv);
}
/* USER CODE END 1 */
