eagletrt/fenice-bms-lv/Core/Inc/template.h

/**
 * @file      template_name.h
 * @author    Author Name [author.name@mailprovider.xxx]
 * @date      DATE
 * @updated   revisions
 * @ingroup  i don't know yet how to use this
 * @prefix   TEMPLATE
 * 
 * @brief     
 * 
 */

/* Define to prevent recursive inclusion -------------------------------------*/
#ifndef _TEMPLATE_H_
#define _TEMPLATE_H_

/* Includes ------------------------------------------------------------------*/
/* Exported types ------------------------------------------------------------*/
/* Exported constants --------------------------------------------------------*/
/* Exported macros -----------------------------------------------------------*/
/* Exported functions --------------------------------------------------------*/
/* Private types -------------------------------------------------------------*/
/* Private variables ---------------------------------------------------------*/
/* Private constants ---------------------------------------------------------*/
/* Private Macros -----------------------------------------------------------*/
#endif
