eagletrt/fenice-bms-lv/Core/Src/common.c

/**
 * @file      common.c
 * @author    Simone Ruffini [simone.ruffini@tutanota.com]
 * @date      2021-04-02
 * @updated
 * @ingroup
 * @prefix
 * 
 * @brief     
 * 
 */
#include "common.h"

#include "usart.h"
