eagletrt/fenice-bms-lv/(commit log)

2019-11-30 Created BMS projext for VScode
2020-01-30 Added pwm
2020-02-21 tested PWM
2020-02-21 add current sensor code -> tested and works
2020-02-22 add current debug menu
2020-02-25 created 2 new projects bms_LV_v2 (to use now) and bms_LV_v4 (to use in the future)
2020-03-01 add voltages send -> to test
2020-03-06 Added pwm struct, pwm output, temperatures struct, PID to control temperatures
2020-03-06 added errors, ON_OFF BMS, error led states
    [main.c, main.h]
2020-11-21 Add STM32F7 documentation and close #1
2020-12-14 changed clk source external->internal. Uart working.
    Thee external clk does not work and LTC does not work too.
    [ffconf.h, main.c, main.h]
2021-07-10 fixes after dir changes
    Code compiles and works
    [adc.c, buzzer.c, common.c, common.h]
2022-04-28 fw:ltc and relay works properly
2022-05-06 fw: fix swapped pumps, add other pump functions
    [main.c, main.h]
2022-05-07 feat: added ADC peripheral for sensors reading
    Features:
    - ADC1 used in DMA mode (DAM2 stream 0), 4 division prescaler, 12 Bit
    resolution, sampling @ 480 ADCLKS per rank, 5 ranks, scan conversion
    enabled, continuous conversion disabled, DMA continous conversion
    enabled, software start, right allignment, EOC = EOC_Sequential,
    - DMA1 stream0 peripheral to memory, half word alligned, circular
    buffer, memory address increase enabled
    - Getters and setters for the peripherals read by the ADC:
    current sensor: HALL, temperature sensors x4: BATT1/2 DCDC12V DCDC24V
    Problems:
    - CubeMX doesn't generate correctly the initialization call of ADC and
    DMA peripherals. The `MX_DMA_Init()` should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
    [adc.c, adc.h, buzzer.c, common.h, fenice-bms-lv.ioc, main.c, main.h]
2022-05-08 fix: DMA init before ADC init
    NOTE:
    - CubeMX code generator initializes the ADC before the DMA this makes
    impossible to use the ADC in DMA mode. A handcrafted fix is applied in
    main.c by disabling the code generation for this two peripherals:
    CubeMX -> Project Manager -> Advanced Settings -> opt in __Do not generate
    function call__ for ADC and DMA
    [fenice-bms-lv.ioc, main.c]
2022-05-09 feat: add feedback control on fan/pumps/radiators startup and change radiators duty cycle range
2022-05-13 feat: add basic can structure
    Improved cli: add temp msg, add radiator info cmd, add volt meas infos
    Volts: defined MIN_POWER_ON_VOLT_VOLTAGE, add errors in volt.h
    [fenice-bms-lv.ioc, fenice-config.h, main.c, main.h]
2022-05-18 feat: add measurements and can messages using timers
    fix: voltage read overwflow wich causes micro ticks reset
    [fenice-bms-lv.ioc, main.c, main.h, tim.c]
2022-05-18 chore: add error handlers (not implemented yet)
    [fenice-bms-lv.ioc, fenice-config.h, main.c, main.h, tim.c]
2022-05-19 chore: add basic errors, also in cli
    errors implementation: not finished yet
    [fenice-bms-lv.ioc, fenice-config.h, main.c, main.h, tim.c]
2022-05-21 feat: ADC api + HALL_OCD as EXTI
    IOC changes:
    - Set PC1 (HALL_OCD) pin as GPIO EXTI rising/falling detection
    ADC:
    - added api for the current transducer
2022-05-23 fix: wrong index for hall sensor
    [adc.c, main.c]
2022-05-24 feat: add error management when volt connector is removed
    [fenice-config.h, main.c, main.h, tim.c]
2022-05-29 fix: doc of current_transducer
2022-05-29 feat: api for thermocouple sensors (no impl.)
2022-06-09 feat: varius changes read below
    CHANGES:
    - ADC readings are spilit between ADC1 and ADC2
    - ADC1 for the current transducer, triggered by HW from TIM5 on
    Capture Compare event on Channel 1, the resulting sampling frequency
    is 200KHz
    - ADC2 for all thermocouples, triggered by SW on the interrupt of TIM7,
    the resulting sampling frequency is 1KHz
    FEATURES:
    - Thermocuples API is implemented but not tested on the actual HW
    - HAL_OCD moved to EXTI line, overcurrent detection triggers an
    interrupt that in turn calls CT_OCD_callback()
2022-06-12 chore: add canlib comms + some fixes
    errors timeout not working
    [main.c, main.h]
2022-06-13 chore: add can send also in the error state
    [main.c]
2022-06-13 feat: add inverter cli msg + minor fixes on pumps control
2022-06-17 fix: change current send from mA to A
2022-06-17 chore: follow can-lib updates
    update current ranges
2022-06-18 chore: following canlib update
    note: open wire check needs to be tested
2022-06-21 feat: add open wire check
    note: add another timer to handle duture measurements (TIM4)
2022-06-22 fix: ltc6810 error is now fatal
    chore: add spi and voltages_not_ready errors
    [main.c]
2022-06-24 fix: placd timeout extended
    [adc.c]
2022-06-24 fix: open wire meas flag
2022-06-25 BREAKING CHANGE: lipo battery is now 3S
    fix: current meas -> 480 samples
    [adc.c, fenice-bms-lv.ioc, fenice-config.h, main.c]
2022-06-25 fix: set radiators and pumps fix
2022-06-25 chore: fix some bugs + change cooling curves
    [fenice-bms-lv.ioc, main.c, main.h, tim.c]
2022-06-26 chore: add basic cooling routine + internal fan
2022-06-28 feat: HO_50S_SP33 adc value is averaged
    FIXES:
    - added unit of measure to MAX_CURRENT_ALLOWED_mA
    - updated sampling time of ADC1 (TIM5 period = 20KHz)
    CHORES:
    - removed avereage function (CT_get_average_electric_current) in
    current_transducer.c/h
    [adc.c, adc.h, fenice-bms-lv.ioc, fenice-config.h, main.c, tim.c]
2022-06-29 chore: introduced adc mean for thermocouples
    chore: add cooling cli message
    chore: add condition on error reset in order to keep the errors after an error
    [adc.c, adc.h, main.h, tim.c]
2022-07-06 chore: remove ERROR_ADC_TIMEOUT
    chore: refactoring here and there
    note: ADC TIMEOUT error removed because it's triggered by hardware
    [main.c, main.h, tim.c]
2022-07-08 chore: error can send
    [main.c, main.h]
2022-07-12 cooling: fixed can communication
    [main.c]
2022-07-12 config: set 4.2 as maximum voltage level
2022-07-12 radiators: fixed speed adjustment
    [main.c]
2022-07-12 chore: little fix in radiators speed
    [main.c]
2022-08-12 fix: pumps now works at 25% too
    [main.c]
2023-10-06 fix: fixed inverter_enable logic
    [fenice-config.h, main.c]
2023-10-06 fix: mean over thc temperatures
    [adc.c, fenice-bms-lv.ioc, main.c, main.h, tim.c]
2023-10-06 added pid cooling to be tested
2023-10-06 chore: update .ioc file and add updated pcb schematic
2023-10-06 chore: add basic structs for adc meas with mux
2023-10-06 feat: add adc readings on multiple multiplexer
2023-10-06 chore: add adc tim routine
2023-10-06 fix: adc meas in dma
    [adc.c, adc.h, main.c, main.h, tim.c]
2023-10-06 feat: add measurement routine fix: adc meas and ioc pinout
    [adc.c, adc.h, fenice-bms-lv.ioc, main.c, main.h, tim.c]
2023-10-06 feat: bms monitor voltage measurement
2023-10-06 feat: add new error library
    [adc.c, fenice-bms-lv.ioc, main.c, main.h, tim.c]
2023-10-06 feat: add error handling
    [adc.c, main.c, main.h, tim.c]
2023-10-06 feat: change bms-monitor configuration to LV config
2023-10-06 fix: cell volt send
    [adc.c, adc.h, main.c, tim.c]
2023-10-06 chore: add error ninis noise
    [main.c]
2023-10-06 feat: add other safety checks + inject signals command to trigger errors
    [fenice-config.h]
2023-10-06 fix: can data send
    [main.c]
2023-10-06 chore: ignore as_system charger
2023-10-06 fix: adc feedbacks position feat: add time set activation from cli
    [adc.c, adc.h, fenice-bms-lv.ioc, main.c, main.h, tim.c]
2023-10-06 feat:time set pin low when in error
    [main.c]
2023-10-06 feat: add inverter discharge pin
2023-10-06 fix: multiplexer configuration for GPIOB and other small fixes
    [adc.c, fenice-bms-lv.ioc, main.c, main.h, tim.c]
2023-10-06 chore: reduce temp sensors check to 30% of the total
2023-10-06 fix: offset temps sensor to read correct values
2023-10-06 fix: inverter upate and small fixes
    [adc.c, main.c]
2023-10-06 Change automatic cooling from PID to linear
