eagletrt/fenice-bms-lv/(notices)

Notices in the files:
Core/Inc/usart.h:
Copyright (c) 2022 STMicroelectronics.
All rights reserved.
This software is licensed under terms that can be found in the LICENSE file
Core/Src/main.c:
© Copyright (c) 2020 STMicroelectronics.
This software component is licensed by ST under Ultimate Liberty license
